LittleJono/4-key-keyboard/3d printed case/2x2casebeveled.stl

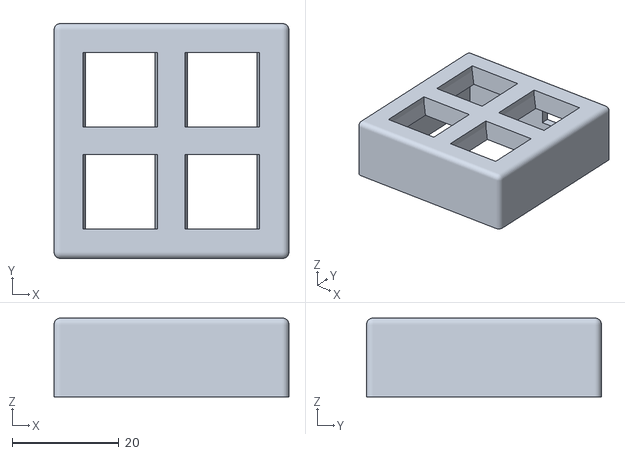
[picture p5: CAD file, 2018-01-31]
3d printed case/2x2casebeveled.stl
44.0 x 44.0 x 14.8
