LittleJono/4-key-keyboard/Acrylic Case/bot.dxf

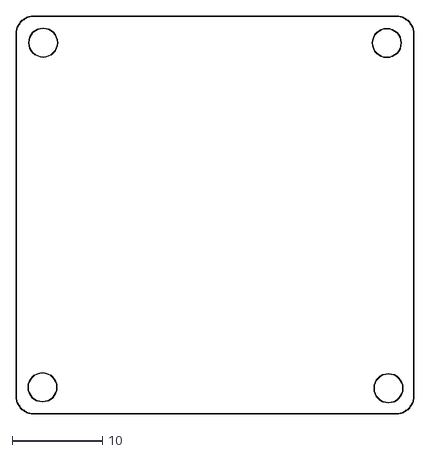
[picture p6: CAD file, 2017-06-12]
Acrylic Case/bot.dxf
44.1 x 44.1
