LittleJono/4-key-keyboard/Acrylic Case/top.dxf

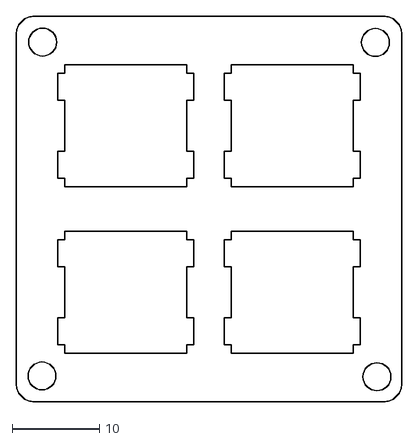
[picture p7: CAD file, 2017-06-12]
Acrylic Case/top.dxf
44.1 x 44.1
